madeinoz67/kicad-library/README.md

# kicad-library

This repository has common [symbols](symbols), [footprints](footprints) and [3d models](3d_models) used across all of
my projects.

## Install

1. In each project, add this repository as a git submodule:

    ```sh
    git submodule add git@github.com:madeinoz67/kicad-library.git hardware/library
    ```
1. Update the git submodule

    ```sh
    git submodule update --remote hardware/library
    ```

## Project Features

* kicad-libary is a collection of common symbols, footprints and 3d models used across projects.
* Documentation using MkDocs Material - <https://squidfunk.github.io/mkdocs-material/>
* A starter KiCad project structured similar to <https://hackaday.com/2017/05/18/kicad-best-practises-library-management/>
* A starter documentation structure based on the <https://hutscape.com/pine/> by Sayanee Basu <https://github.com/sayanee> and her great youtube video around hardware documentation <https://youtu.be/uPitFGqjyPU>.

## Resources

Below are some handy resource links.

* [KiCad](https://www.kicad.org/) is a Cross Platform and Open Source Electronics Design Automation suite.
* [cookiecutter-kicad](https://github.com/madeinoz67/cookiecutter-kicad) a cookiecutter template for KiCad Projects used to create this project.

## Authors

* **Stephen Eaton** - *Initial Work* - [github](https://github.com/madeinoz67)

See also the list of [contributors](https://github.com/madeinoz67/kicad-libs/AUTHORS.rst) who participated in this project.
