madeinoz67/kicad-library/docs/index.md

# Welcome to kicad-library

KiCad Libraries that are used across my projects

--8<-- "./README.md"

    mkdocs.yml    # The configuration file.
    docs/
        index.md  # The documentation homepage.
        ...       # Other markdown pages, images and other files.
