madeinoz67/kicad-library/footprints/3d_models/ESOP-8_L4.9-W3.9-P1.27-LS6.0-TL-EP.step

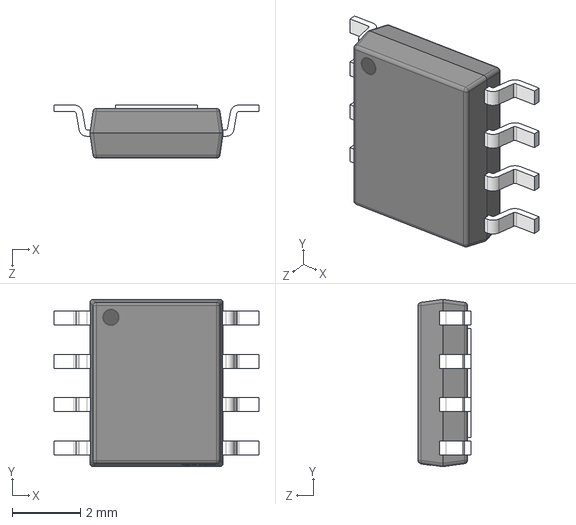
[picture p1: CAD file, 2025-01-12]
footprints/3d_models/ESOP-8_L4.9-W3.9-P1.27-LS6.0-TL-EP.step
6.00 x 4.90 x 1.55 mm
