madeinoz67/kicad-library/footprints/3d_models/ESOP-8_L4.9-W3.9-P1.27-LS6.0-BL-EP.step

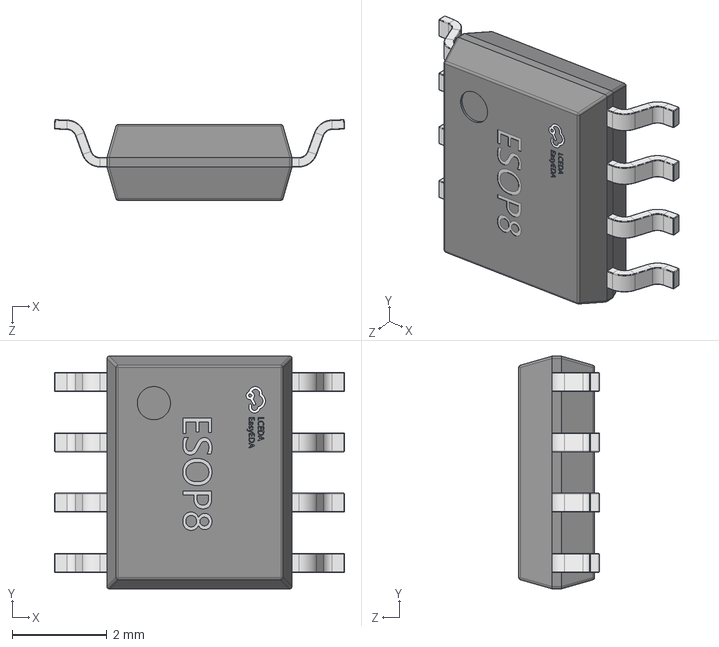
[picture p2: CAD file, 2025-01-12]
footprints/3d_models/ESOP-8_L4.9-W3.9-P1.27-LS6.0-BL-EP.step
6.11 x 4.90 x 1.70 mm
