madeinoz67/kicad-library/footprints/3d_models/1042.stp

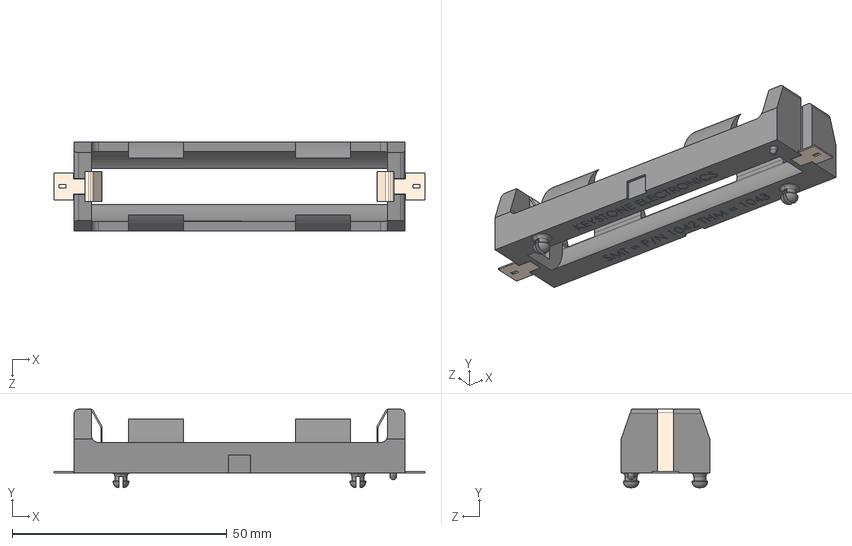
[picture p3: CAD file, 2025-01-11]
footprints/3d_models/1042.stp
86.4 x 18.3 x 20.6 mm
