madeinoz67/kicad-library/footprints/3d_models/LQH3NPZ220MMEL.step

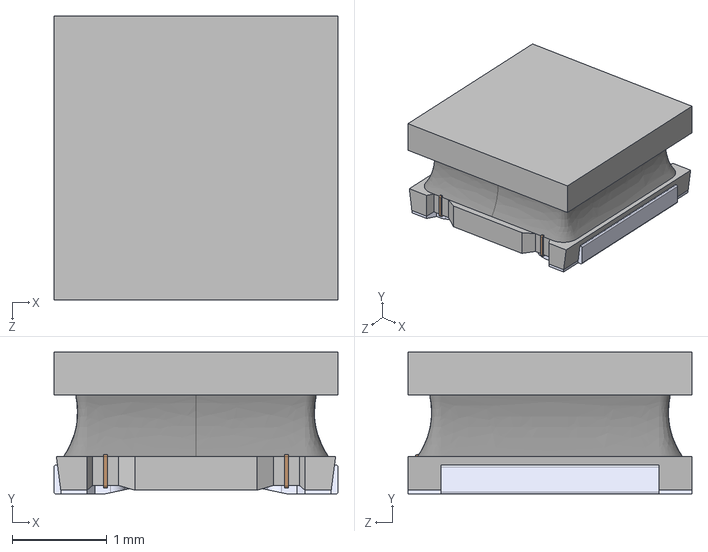
[picture p4: CAD file, 2025-01-11]
footprints/3d_models/LQH3NPZ220MMEL.step
3.00 x 1.50 x 3.00 mm
