madeinoz67/kicad-library/footprints/3d_models/CUI_DEVICES_PJ-036AH-SMT-TR.step

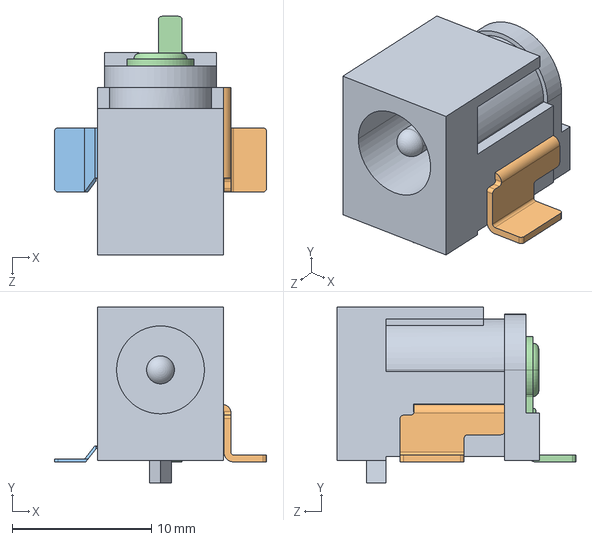
[picture p6: CAD file, 2022-07-15]
footprints/3d_models/CUI_DEVICES_PJ-036AH-SMT-TR.step
15.2 x 12.6 x 17.1 mm
