madeinoz67/kicad-library/footprints/3d_models/USB_Micro-B_Connector_SMD_7.5x6.3mm.step

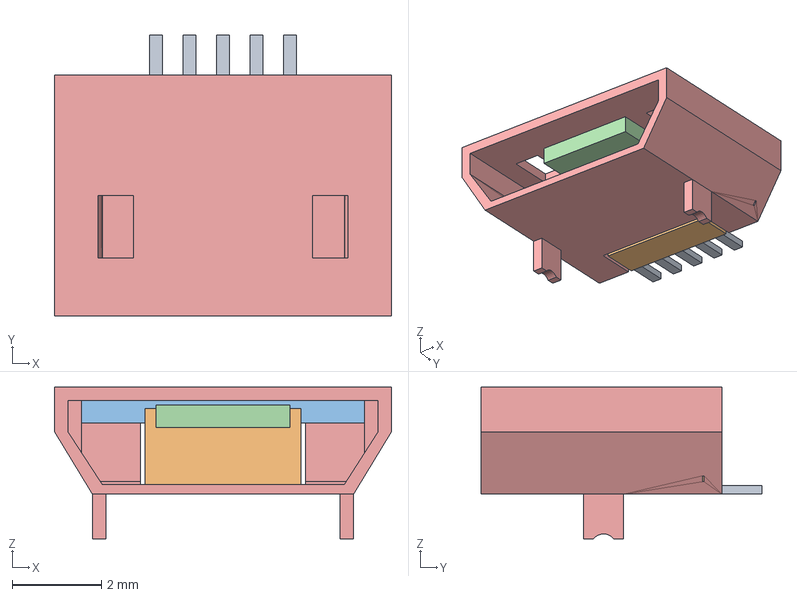
[picture p7: CAD file, 2022-07-10]
footprints/3d_models/USB_Micro-B_Connector_SMD_7.5x6.3mm.step
7.55 x 6.30 x 3.40 mm
USB_Micro_B_Connector_SMD_7_5x6_3mm_2_Solid__8_001001_(Solid)
USB_Micro_B_Connector_SMD_7_5x6_3mm_2_Solid__7_001001_(Solid)
USB_Micro_B_Connector_SMD_7_5x6_3mm_2_Solid__6_001001_(Solid)
USB_Micro_B_Connector_SMD_7_5x6_3mm_2_Solid__5_001001_(Solid)
USB_Micro_B_Connector_SMD_7_5x6_3mm_2_Solid__4_001001_(Solid)
USB_Micro_B_Connector_SMD_7_5x6_3mm_2_Solid__3_001001_(Solid)
USB_Micro_B_Connector_SMD_7_5x6_3mm_2_Solid__2_001001_(Solid)
USB_Micro_B_Connector_SMD_7_5x6_3mm_2_Solid001001_(Solid)
USB_Micro_B_Connector_SMD_7_5x6_3mm_2_Solid__9_001001_(Solid)
