madeinoz67/kicad-library/footprints/3d_models/USB_2_Type_B_Connector_ThruHole.stp

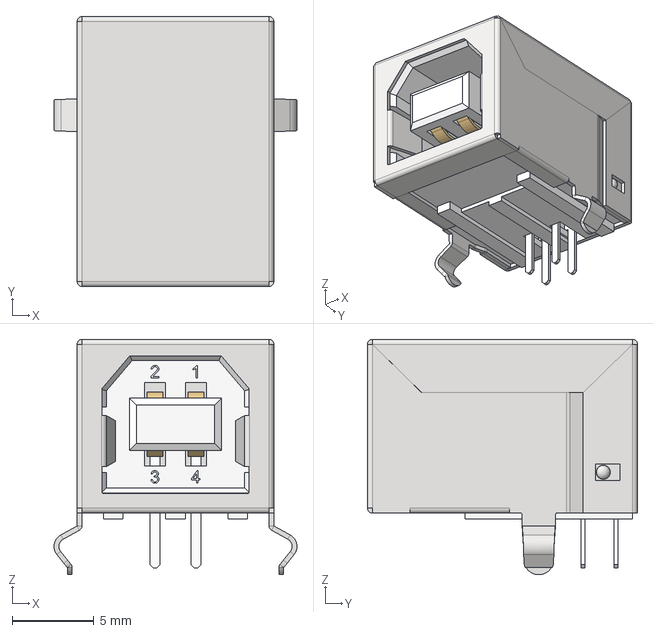
[picture p8: CAD file, 2022-07-10]
footprints/3d_models/USB_2_Type_B_Connector_ThruHole.stp
14.8 x 16.5 x 14.4 mm
