madeinoz67/kicad-library/footprints/3d_models/SW_SMD_SPST_Side_6.3x6.7.step

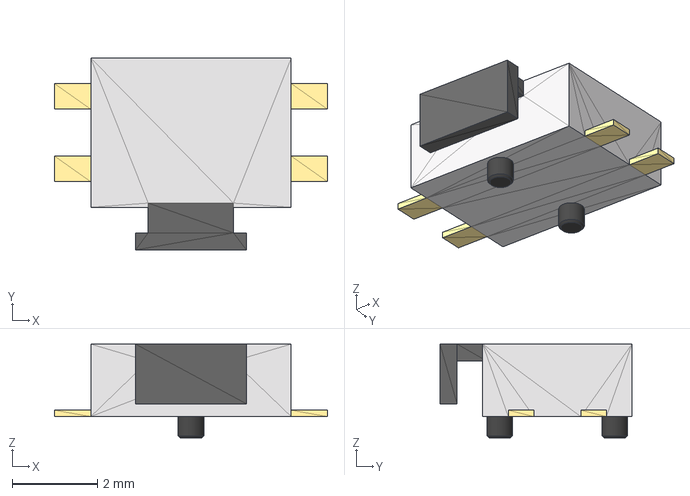
[picture p9: CAD file, 2022-07-10]
footprints/3d_models/SW_SMD_SPST_Side_6.3x6.7.step
6.40 x 4.50 x 2.20 mm
