madeinoz67/kicad-library/footprints/3d_models/SW_SMD_SPDT_Slide_8.6x5.6v1.1.step

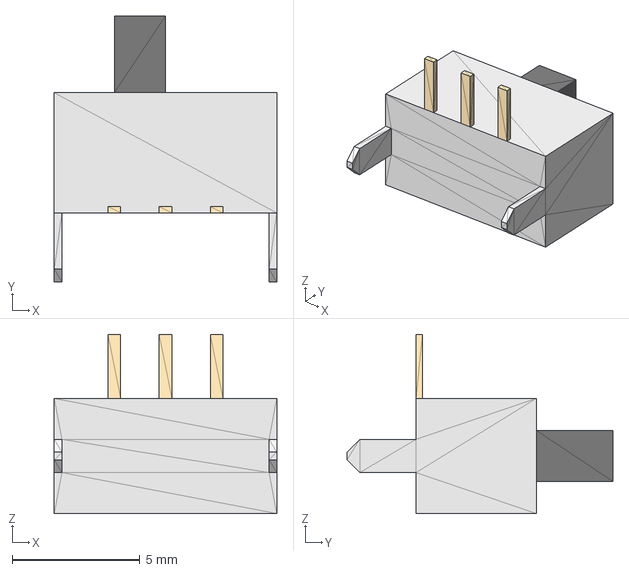
[picture p10: CAD file, 2022-07-10]
footprints/3d_models/SW_SMD_SPDT_Slide_8.6x5.6v1.1.step
8.70 x 10.4 x 7.00 mm
