madeinoz67/kicad-library/footprints/3d_models/SW_SMD_SPDT_Slide_7.8x3.75.step

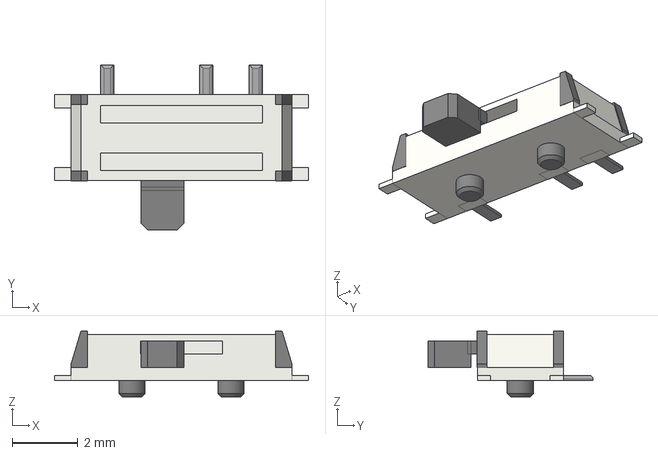
[picture p11: CAD file, 2022-07-10]
footprints/3d_models/SW_SMD_SPDT_Slide_7.8x3.75.step
7.70 x 5.00 x 2.00 mm
