madeinoz67/kicad-library/footprints/3d_models/SW_SMD_SPDT_Top_Slide_7.8x3.75.step

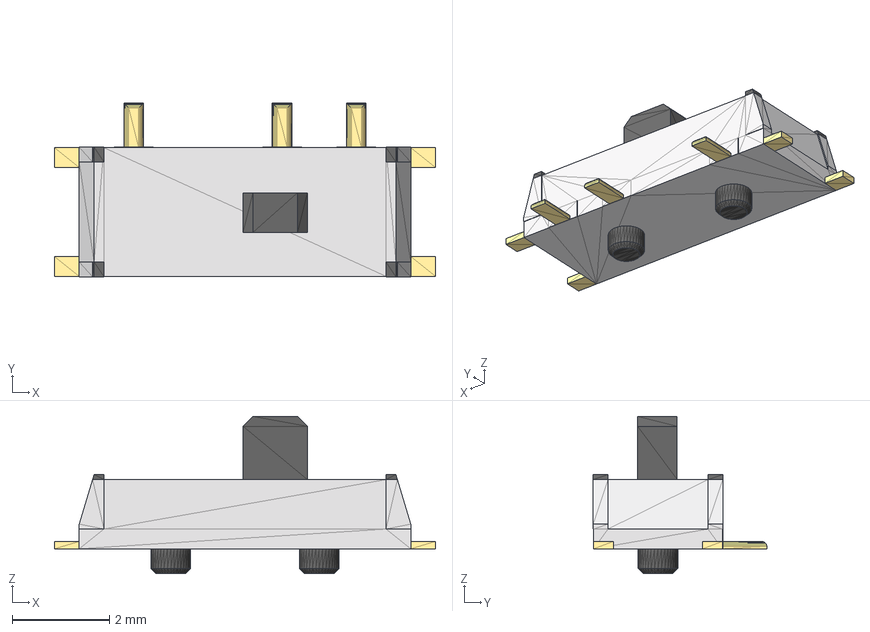
[picture p12: CAD file, 2022-07-10]
footprints/3d_models/SW_SMD_SPDT_Top_Slide_7.8x3.75.step
7.82 x 3.57 x 3.23 mm
Design2_1_Solid006_(Solid)001
