madeinoz67/kicad-library/footprints/3d_models/SW_SMD_SPST_FSMSM.step

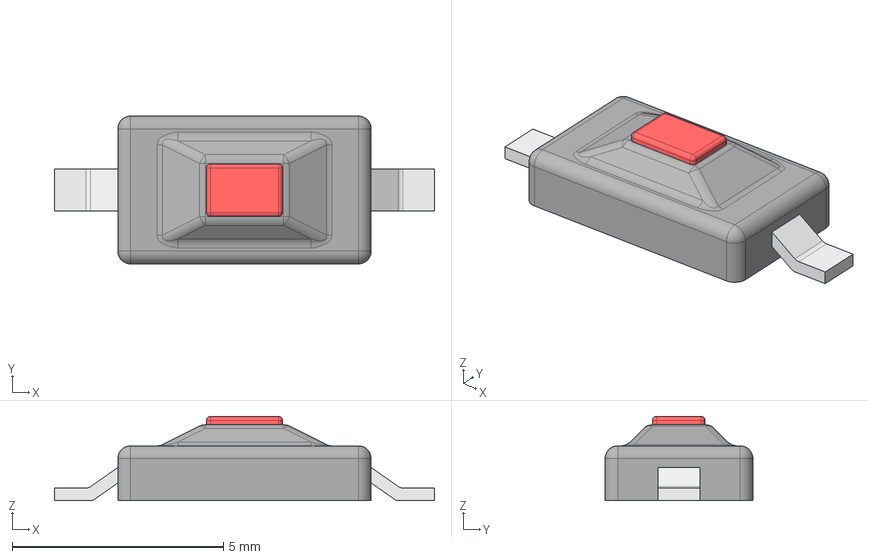
[picture p13: CAD file, 2022-07-10]
footprints/3d_models/SW_SMD_SPST_FSMSM.step
9.00 x 3.50 x 2.00 mm
pines
cuerpo
boton
