madeinoz67/kicad-library/footprints/3d_models/USB_Micro-B_Connector_SMD_7.5x5.6mm.step

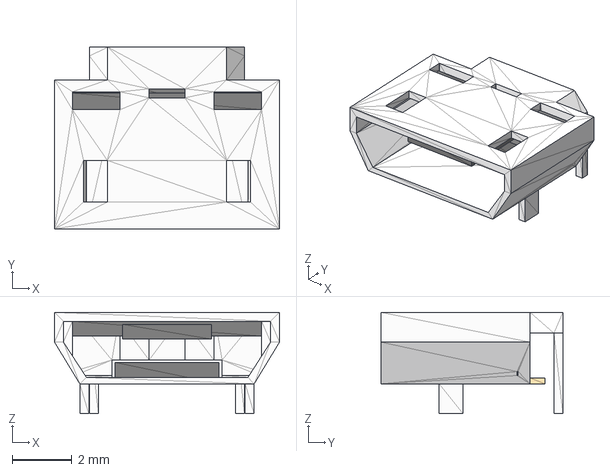
[picture p14: CAD file, 2022-07-10]
footprints/3d_models/USB_Micro-B_Connector_SMD_7.5x5.6mm.step
7.55 x 6.10 x 3.40 mm
