madeinoz67/kicad-library/footprints/3d_models/SW_SMD_SPST_6x6.5x5.step

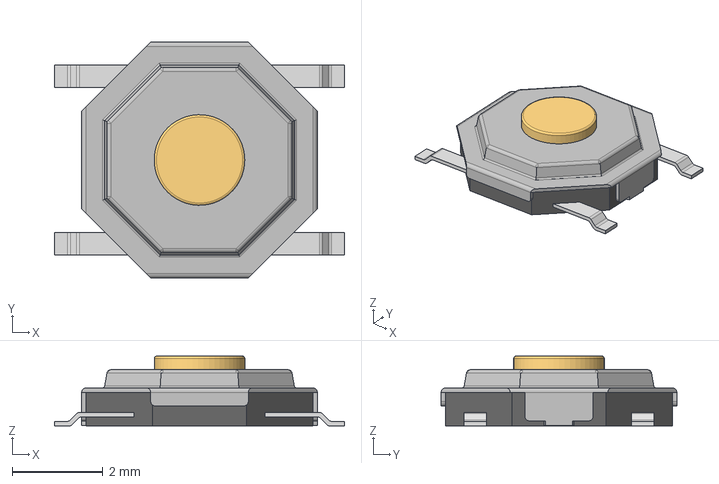
[picture p15: CAD file, 2022-07-10]
footprints/3d_models/SW_SMD_SPST_6x6.5x5.step
6.40 x 5.20 x 1.54 mm
