madeinoz67/kicad-library/footprints/3d_models/SW_PUSH_6mm_H4.3mm.step

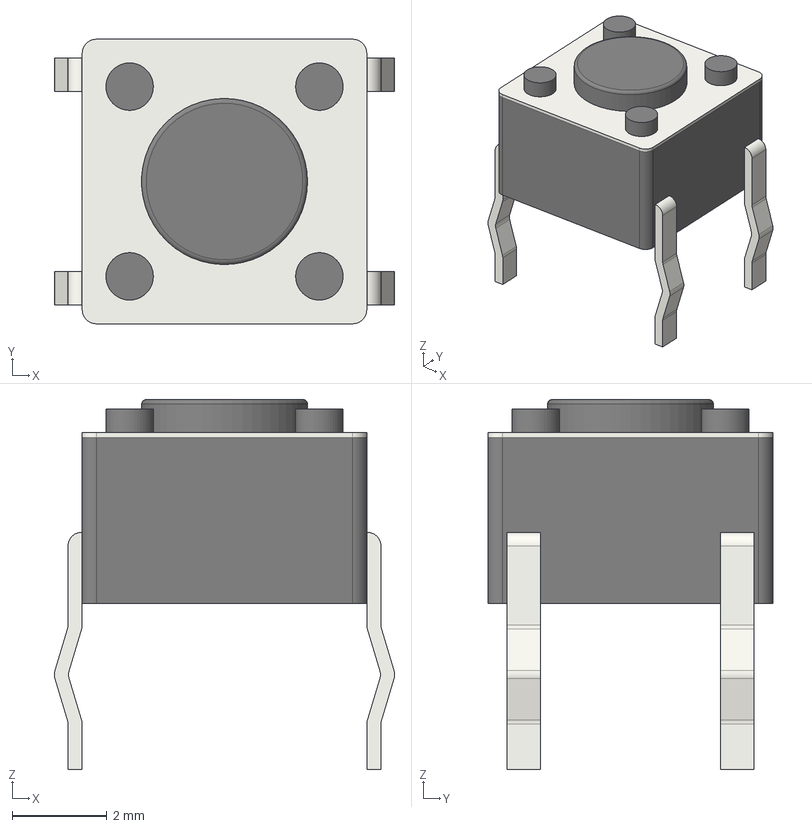
[picture p16: CAD file, 2022-07-10]
footprints/3d_models/SW_PUSH_6mm_H4.3mm.step
7.17 x 6.00 x 7.80 mm
