madeinoz67/kicad-library/footprints/3d_models/SW_TH_SPST_6x6.5_H5mm.step

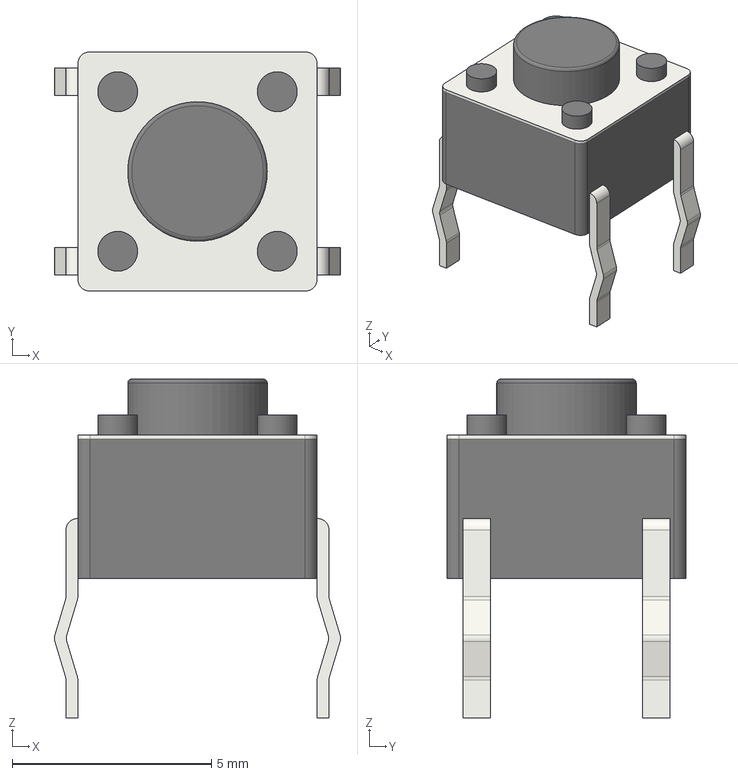
[picture p17: CAD file, 2022-07-10]
footprints/3d_models/SW_TH_SPST_6x6.5_H5mm.step
7.17 x 6.00 x 8.50 mm
