madeinoz67/kicad-library/footprints/3d_models/USB_Mini-B_Connector.step

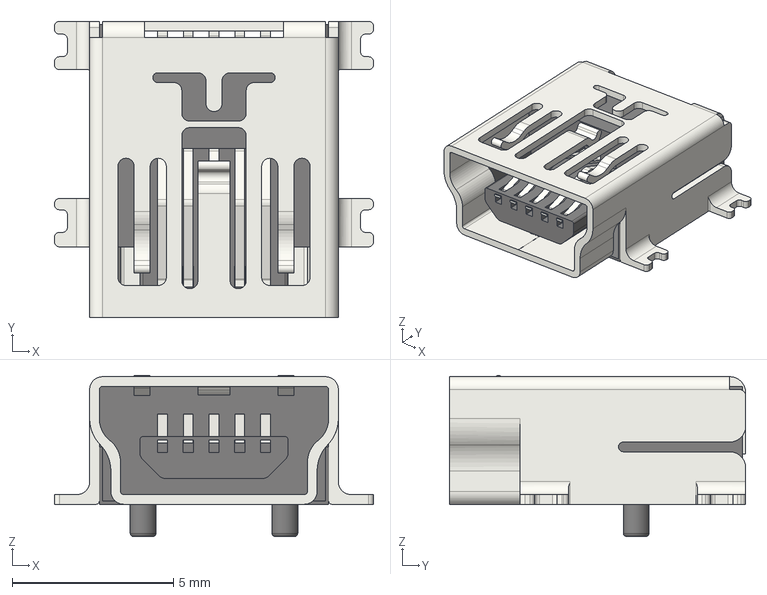
[picture p18: CAD file, 2022-07-10]
footprints/3d_models/USB_Mini-B_Connector.step
9.90 x 9.20 x 5.00 mm
