madeinoz67/kicad-library/footprints/3d_models/USB 2_Type_A_Connector_ThruHole.stp

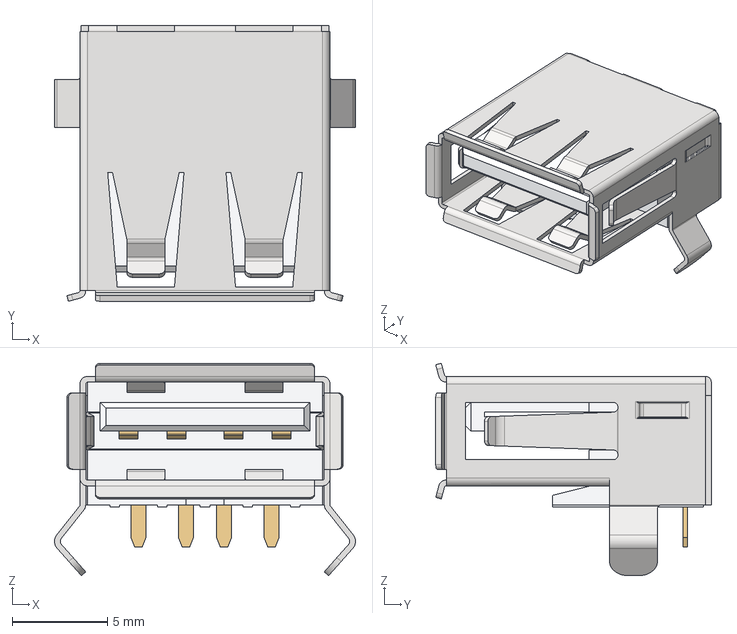
[picture p19: CAD file, 2022-07-10]
footprints/3d_models/USB 2_Type_A_Connector_ThruHole.stp
15.8 x 14.4 x 11.1 mm
