madeinoz67/kicad-library/footprints/3d_models/SW_SMD_SPST_8x3.6.step

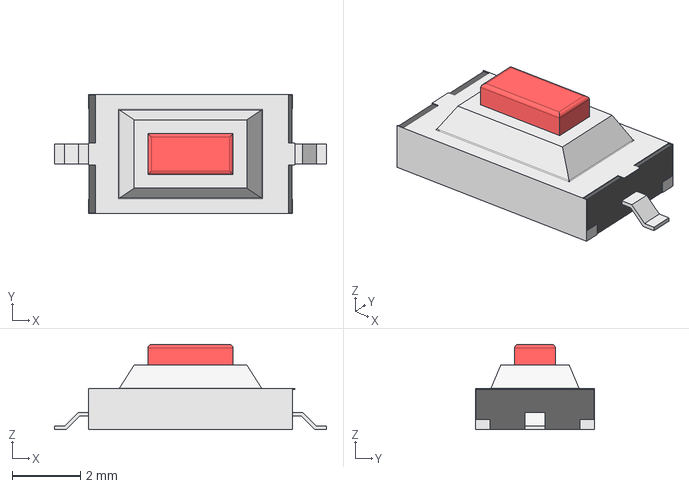
[picture p20: CAD file, 2022-07-10]
footprints/3d_models/SW_SMD_SPST_8x3.6.step
8.00 x 3.50 x 2.50 mm
