madeinoz67/kicad-library/footprints/3d_models/SW_SMD_SPDT_Slide_9x6.9-hole.step

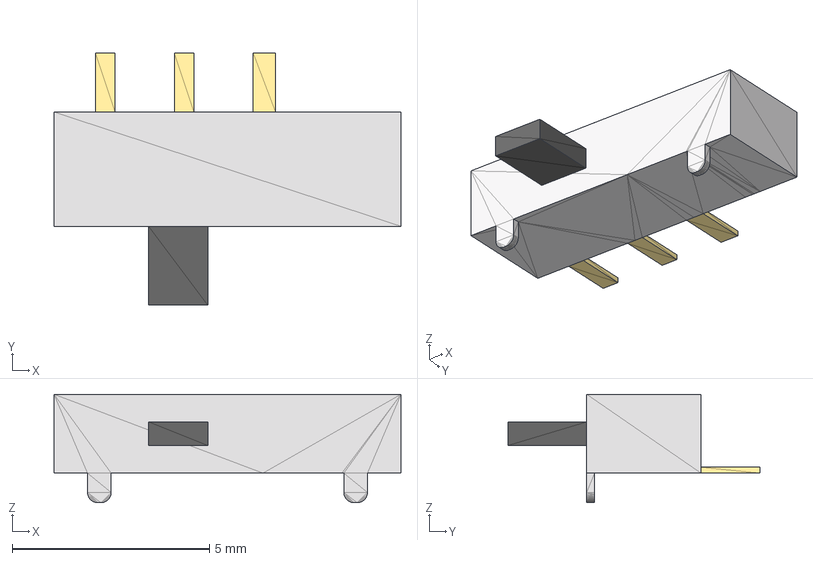
[picture p21: CAD file, 2022-07-10]
footprints/3d_models/SW_SMD_SPDT_Slide_9x6.9-hole.step
8.80 x 6.40 x 2.75 mm
SW_SMD_SPDT_Slide_9x6_9_hole_Solid002_(Solid)
SW_SMD_SPDT_Slide_9x6_9_hole_Solid__2_001_(Solid)
SW_SMD_SPDT_Slide_9x6_9_hole_Solid__3_001_(Solid)
SW_SMD_SPDT_Slide_9x6_9_hole_Solid__4_001_(Solid)
SW_SMD_SPDT_Slide_9x6_9_hole_Solid1001_(Solid)
