madeinoz67/kicad-library/footprints/3d_models/SW_SMD_SPST_5x3.step

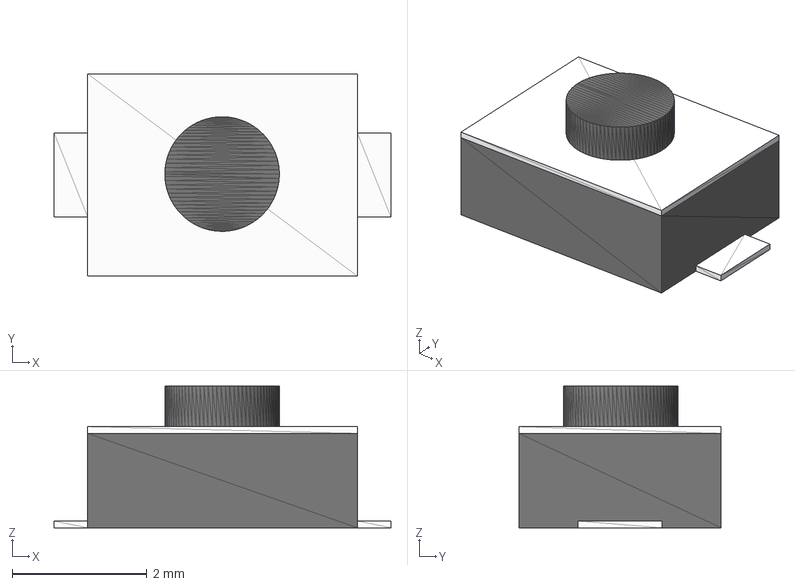
[picture p22: CAD file, 2022-07-10]
footprints/3d_models/SW_SMD_SPST_5x3.step
5.00 x 3.00 x 2.10 mm
