madeinoz67/kicad-library/footprints/3d_models/USB_C_Connector_9x8mm.1.step

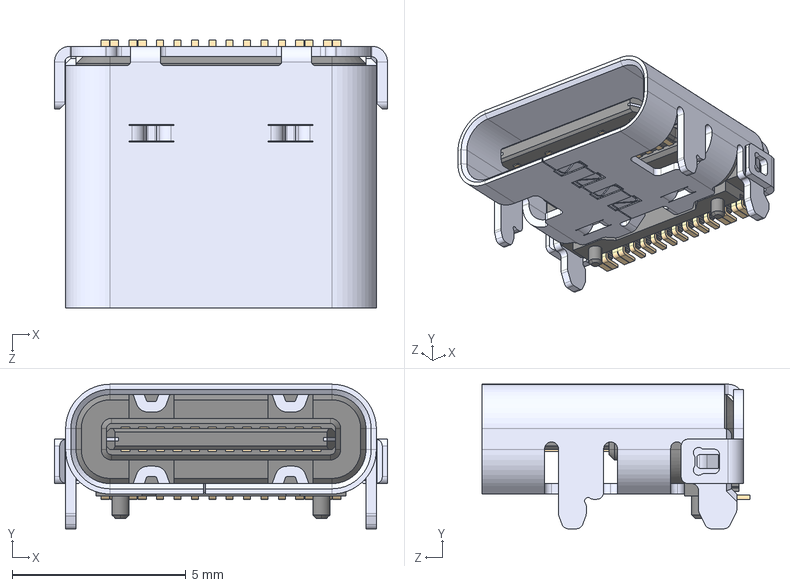
[picture p23: CAD file, 2022-07-10]
footprints/3d_models/USB_C_Connector_9x8mm.1.step
9.58 x 4.16 x 7.71 mm
