madeinoz67/kicad-library/footprints/3d_models/WS2812B.step

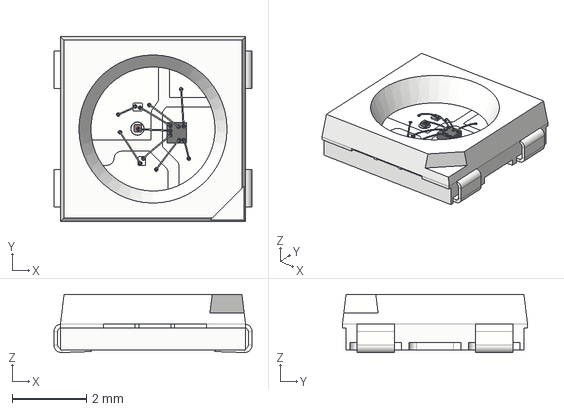
[picture p24: CAD file, 2022-07-04]
footprints/3d_models/WS2812B.step
5.35 x 5.00 x 1.57 mm
