madeinoz67/kicad-library/footprints/3d_models/SMD WS2812B Mini.step

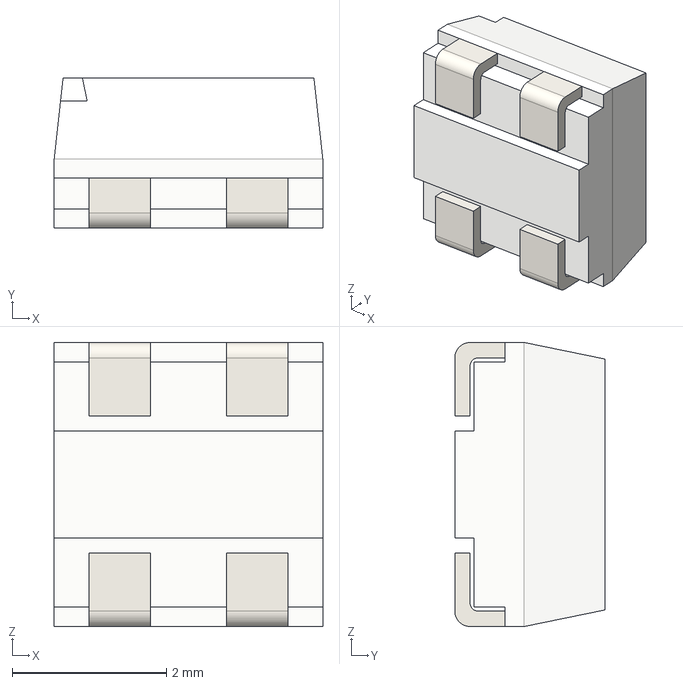
[picture p25: CAD file, 2022-07-04]
footprints/3d_models/SMD WS2812B Mini.step
3.48 x 1.95 x 3.68 mm
