madeinoz67/kicad-library/footprints/3d_models/ESP32-C3-MINI-1-N4.step

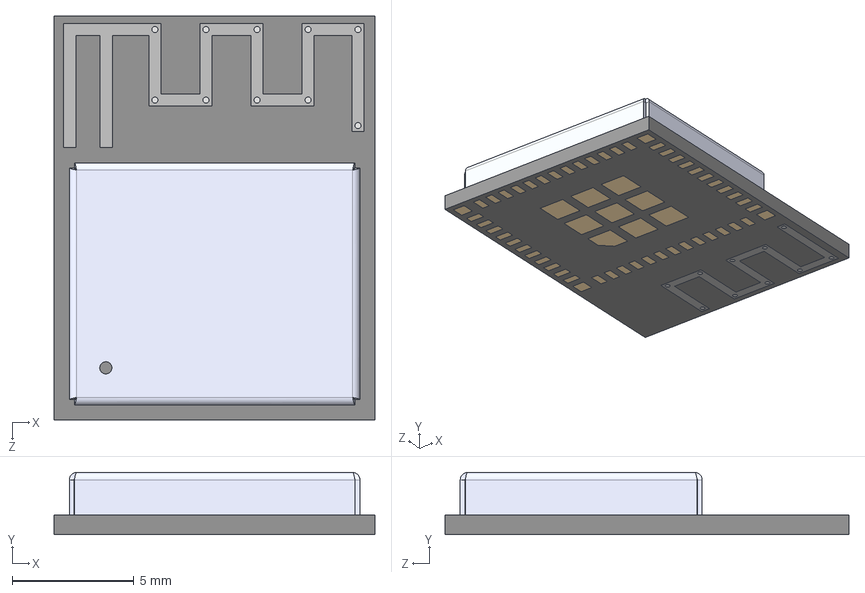
[picture p26: CAD file, 2022-06-27]
footprints/3d_models/ESP32-C3-MINI-1-N4.step
13.2 x 2.55 x 16.6 mm
