madeinoz67/kicad-library/(list of files, cad)

Other CAD files:
footprints/3d_models/18650 Li Ion Battery.STEP
footprints/3d_models/MAX17048G+T10.stp
footprints/3d_models/MLX90614ESF-BAA-000-TU.step
