madeinoz67/kicad-library/(commit log)

2022-06-27 Added ESP32-C3-MINI-1-N4 symbos, footprint and step Added MOSFET symbols Added Fuses symbols
    [ESP32-C3-MINI-1-N4.step]
2022-07-04 Added Footptints associated with STR-21-007
    [MLX90614ESF-BAA-000-TU.step, SMD WS2812B Mini.step, WS2812B.step]
2022-07-10 Added Libraries from Parkview
    [SW_PUSH_6mm_H4.3mm.step, SW_SMD_SPDT_Slide_7.8x3.75.step, SW_SMD_SPDT_Slide_8.6x5.6v1.1.step, SW_SMD_SPDT_Slide_9x6.9-hole.step, SW_SMD_SPDT_Top_Slide_7.8x3.75.step, SW_SMD_SPST_5x3.step, SW_SMD_SPST_6x6.5x5.step, SW_SMD_SPST_8x3.6.step]
2022-07-11 PDFN3333 footprint added Fixed some previosu footprints
2022-07-15 added LCSC footprints for DFN3333
    [CUI_DEVICES_PJ-036AH-SMT-TR.step, SSD1306_OLED_Display(128x64).step]
2022-07-22 removed paste on holes
2023-08-26 Added Passive Footprints
2025-01-01 Added QFN16 footprint and 3D model
2025-01-04 Added Battery Management
2025-01-06 rejigged pins visibility to make schematic clearer, seperated off thermal_gnd
2025-01-08 Migrated library and Fixed mini switch grid alignment
2025-01-08 Fixed symbol hidden NC pins and hidden ground
2025-01-09 Fixed ESP32-C4-Mini-1 GND and Thermal Pads on symbol
2025-01-11 Added 22uH, 540mA inductor
    [LQH3NPZ220MMEL.step]
2025-01-11 Added Keystone 182650 Battery Holder footprint and 3d model
    [1042.stp]
2025-01-11 Addedc Max17048 Better gauge footprint and 3d model
    [MAX17048G+T10.stp]
2025-01-12 Move all footprints under single directory, moved 3d director under footprints dir
    [1042.stp, CUI_DEVICES_PJ-036AH-SMT-TR.step, ESOP-8_L4.9-W3.9-P1.27-LS6.0-BL-EP.step, ESOP-8_L4.9-W3.9-P1.27-LS6.0-TL-EP.step, ESP32-C3-MINI-1-N4.step, LQH3NPZ220MMEL.step, MAX17048G+T10.stp, MLX90614ESF-BAA-000-TU.step]
2025-01-19 Added 3d model for 18650 battery
    [18650 Li Ion Battery.STEP]
2025-01-19 added L_1008 inductor footprint
2025-01-19 updated pin types in symbols
2025-01-28 Added CJ6211B33M LDO regulator
2025-01-28 Added CJ2301 P-Channel FET
